EdduDesarrollo/digitalizadora-films/README.md

**Español** | [English](docs/README.en.md)

# AGU printer film scanner
La digitalización de películas fotoquímicas es una necesidad de todos los archivos y colecciones.
A pesar de que en los últimos años han bajado considerablemente los costos de los equipos necesarios, todavía es inaccesible para los archivos y colecciones pequeñas.
Con esto en mente, en el Espacio de digitalización de documentos universitarios del Archivo General de la UDELAR nos abocamos a la tarea de desarrollar un sistema de escaneo de bajo costo y replicable por otras instituciones y particulares que cumpla con ciertos criterios de calidad y sustentabilidad.



## Componentes



1. Una impresora de tickets de las utilizadas en los puestos de venta.



2. Una cámara digital compatible con el software [gphoto2](http://www.gphoto.org/proj/libgphoto2/support.php).

3. Un lente macro o aros de extensión.

4. Una computadora de mediana potencia con sistema operativo Ubuntu.



5. Un plafón de iluminación led cuadrado de aprox 11 cm de lado.



6. Partes que fueron impresas en 3D:
Soporte y agarraderas para plafón de iluminación.

Base, tapa y trancas para películas de 16mm y 35mm.

7. Un tablón de madera como base de todos los elementos.

8. Un pie de ampliadora como soporte de la cámara.

9. Dos antiguas rebobinadoras de película.

## Principio de funcionamiento



Se utiliza el mecanismo de mover el papel de la impresora para traccionar la película. Para ello es necesario hacerle unas pequeñas modificaciones:

1. Tapar el sensor de falta de papel con un adhesivo.



2. Realizar un pequeño corte en el plástico de la tapa por donde va a entrar la película.



3. Remover el eje de la tapa para poder quitarla al enhebrar la película.



Para este proceso no es exclusivo contar con una impresora de tickets, sino que puede utilizarse cualquier impresora térmica genérica. No obstante, las modificaciones podrían tener que adaptarse a la forma de la impresora.

4. Como fuente de luz se utiliza un plafón genérico de led.

5. Se realizan unas piezas impresas en 3D para colocar la fuente de luz a la misma altura que la entrada de la cinta en la impresora y unas guías para llevar la película sobre la ventana hecha en el soporte.

<em>Los archivos .stl están en la carpeta <a href="docs/">docs</a> del repositorio</em>

6. La cámara con lente macro se sitúa sobre el soporte a una altura adecuada para encuadrar el fotograma. En nuestro caso usamos un pie de una vieja ampliadora fotográfica para sostener la cámara.



7. Tanto la cámara como la impresora se conectan con la computadora mediante cables usb por lo que no es necesario realizar ningún tipo de conexión extra ni soldaduras.

## Software

Print-Scanner_es

Todo el sistema se maneja con una app que controla la cámara mediante la librería gphoto2 y manipula las imágenes mediante opencv. Por el momento, esta app funciona sólo sobre sistema operativo linux pero es posible portarlo a macOS.

Cuando se comienza a utilizar el software por primera vez, es necesario ingresar:

1. Número de serie de la cámara
2. El prefijo del código de referencia (Ej: UY-UDELAR-AGU-AIH). Todo nuestro acervo está dentro de este código por lo que lo usamos como prefijo para todas las digitalizaciones.
3. Seleccionar el directorio donde se van a guardar las imágenes.
4. Ingresar el código de referencia a escanear (Lo que seguiría luego del prefijo - Ej: I-AGU-02-01)
5. Luego, se debe seleccionar el formato de la película. Por el momento, el sistema funciona con películas de 16 mm (se está trabajando para incluir también las de 35 mm, aunque aún no se ha puesto a prueba con el acervo del archivo). En el futuro también se podrá trabajar con películas de 8mm y Súper 8.
 
Una vez que se selecciona el formato, en la interfaz del programa se verá el liveview  (visualización en directo) que toma la cámara con tres líneas azules superpuestas al liveview, que sirven para alinear la cámara con la película, el área en rojo donde el sistema buscará la perforación, además de algunos botones de configuración y reproducción  en la parte inferior derecha de la pantalla y en la parte inferior cuatro botones (Digitalizar, Pausar, Mover 1px y Frame x Frame).

Antes de comenzar es necesario ajustar el foco y otras configuraciones de la cámara.
Esto se hace a través del programa Entangle, al cual se puede acceder a través del botón “Ajustes” (tecla E). Una vez realizados los ajustes, se debe retornar al liveview y configurar el nivel de umbralización (tecla Y) para que se pueda detectar las perforaciones. Una vez configurado el nivel de umbralización se tiene que setear el nivel mínimo de pixeles blancos. Para esto es necesario "Activar Debug" (o tecla G), la pantalla se pintará de rojo, y comenzar la digitalización (tecla Z).
En ese momento se abren dos ventanas, una con los datos analizados y otra con lo que está detectando en la zona donde busca la perforación.
En ese momento se pueden hacer tres acciones: 
1. Cerrar las ventanas con la tecla Q.
2. Avanzar el film un píxel para que analice nuevamente la nueva posición con la tecla E _(Funciona solo en el debug)_.
3. Desactivar el modo Debug y reanudar la digitalización de forma normal con la tecla R.

Lo que nos sirve en esta etapa es avanzar un píxel hasta que la perforación esté completa en la ventana de búsqueda para ver la cantidad de pixeles blancos para ingresar ese valor, o unos pixeles menos, en la opción "Umbral Px Blancos" (tecla U). Luego, si está todo correcto, se puede comenzar el escaneo.

El botón de "Mover 1px" (tecla C) permite avanzar de a un píxel hasta la parte que se quiere empezar a digitalizar.
El botón de "Pausar" (tecla P), sirve para pausar la digitalización en cualquier momento.
Para comenzar el escaneo basta con hacer clic en el botón "Digitalizar" (tecla Z).
 
## Escaneo

El escaneo comienza con la identificación de la perforación mediante el conteo de la cantidad de píxeles blancos en la zona indicada con el recuadro rojo. De no identificar la perforación, la impresora mueve la película de a un píxel hasta encontrar la perforación.

Para los casos con más de una perforación por cuadro, como las películas de 35 mm, el sistema cuenta las perforaciones hasta identificar el cambio de cuadro. Luego de esto, el proceso de digitalización es el mismo.

Por el momento, los carretes no cuentan con motores, por lo que es necesario que una persona suelte y recoja la película manualmente. Para acelerar el proceso de escaneo, el sistema no guarda las imágenes en la carpeta de destino sino que  los archivos raws (tif, cr3, u otros según la cámara) se guardan en la tarjeta de memoria de la cámara y se guarda la relación del nombre de la imagen de la cámara con el nombre que debería tener. Cuando existe un archivo raw en la cámara, el botón “Descargar Raws” cambia a color rojo, avisando que hay archivos pendientes de descarga.

Durante el proceso de escaneo es necesario limpiar todo el sistema cada cierta cantidad de fotos por lo que lo configuramos para que se detenga cada 500 cuadros. Usando aire (pera de goma o aire comprimido) se limpia la zona que se captura removiendo cualquier impureza que se pudo haber desprendido de la película. También aprovechamos esa pausa para descargar las imágenes raws, donde el sistema descargará las imágenes y las renombra con el nombre y número que se configuró.
 
## Posproducción

Una vez que el escaneo de la película está finalizado, se obtiene una secuencia de fotos digitales numeradas en correspondencia con los cuadros fotoquímicos de la película original. Luego de esto, es necesario un proceso de estabilización digital para corregir los pequeños desfasajes en la toma de las fotos digitales. Una posibilidad para hacerlo es mediante el software de edición de video Davinci Resolve, que tiene una versión gratuita. 
 
## Ventajas y desventajas

La principal ventaja de este sistema es su bajo costo. El componente más caro es la cámara fotográfica, aunque puede utilizarse una cámara sencilla que cumpla con los requisitos de ser compatible con gphoto 2 y contar con un lente macro. Al tratarse de un sistema modular, puede mejorarse progresivamente si se dispone de un presupuesto mayor. En el AGU se utilizó una cámara sin espejo ya descontinuada, de 32 megapíxeles, suficiente para obtener una resolución de 4K (aprox. USD 700), un lente de 50mm (aprox. USD 300) y aros de extensión (aprox. USD 100). La computadora empleada es una de las disponibles en el archivo, con una antigüedad de cuatro años. Las piezas impresas en 3D se produjeron con un equipo muy sencillo, que costó unos USD 300, aunque también pueden fabricarse mediante servicios externos de impresión.

Otra ventaja es su sencillez, dado que no es necesario contar con un conocimiento avanzado de informática para instalar y operar el sistema. El sistema también destaca por su versatilidad. Si bien el diseño se desarrolló inicialmente para la digitalización de películas de 16mm, que conforman la parte más voluminosa del acervo del AGU, es posible adaptar las guías y la app para otros formatos.

Una desventaja es que, por el momento, el sistema solamente puede utilizarse en Ubuntu. Aunque es posible migrarlo a macOS mediante algunas modificaciones, aún no puede ejecutarse en Windows, dado que la librería gphoto2 no es compatible con ese entorno.
 
## Próximos pasos

Como se mencionó anteriormente, este es un proyecto en desarrollo. Tras ponerlo a prueba durante los últimos meses identificamos algunas mejoras a realizar:
- Motorizar los carretes de alimentación de película.
- Desarrollar la adaptación para películas de 35 y 8 mm.
- Mejoras estéticas en la interfaz de usuario.

## Guía de Instalación, Configuración y Ejecución de la app

Este documento proporciona los pasos necesarios para preparar y ejecutar la app correctamente.

## Paso 1: Instalar Python 3

Asegúrate de tener Python 3 instalado en tu sistema. Puedes instalarlo desde apt usando la terminal.

   ```bash
   sudo apt update
   sudo apt install python3 python3-pip
   ```

Para corroborar que python3 haya sido instalado correctamente puedes ejecutar el siguiente comando en la terminal:
   ```bash
   python3 --version
   ```

## Paso 2: Instalar dependencias de la app

1. **Instalar paquetes del sistema y acceso directo:**

   Abre una terminal y ejecuta el siguiente comando, desde la raíz del repositorio, para instalar las dependencias de la app:

   ```bash
   python3 print_scanner_app/installer/install.py
   ```

2. **Verificar el Acceso Directo:**

   Ahora deberías ver el acceso directo en tu escritorio. Haz doble clic para ejecutar el programa.

## Paso 3: Obtener el Número de Serie de la Cámara Usando la Terminal

1. **Conectar la Cámara:**

   Asegúrate de que tu cámara esté conectada al puerto USB de tu computadora.

2. **Listar Dispositivos Conectados:**

   Ejecuta el siguiente comando para listar los dispositivos conectados y verificar que tu cámara sea reconocida:

   ```bash
   gphoto2 --auto-detect
   ```

   Esto debería mostrar una lista de dispositivos conectados, incluyendo tu cámara.

3. **Obtener el Número de Serie:**

   Una vez que hayas confirmado que la cámara está conectada y reconocida, ejecuta el siguiente comando para obtener el número de serie:

   ```bash
   gphoto2 --get-config serialnumber
   ```

   Este comando debería devolver el número de serie de la cámara.

   Al iniciar el programa te pedirá el número de serie de la cámara si no está configurado en el archivo config.json

---

Con estos pasos completados, deberías estar listo para ejecutar la app sin problemas.
Si encuentras algún problema, revisa cada paso para asegurarte de que todo esté configurado correctamente.
