EdduDesarrollo/digitalizadora-films/Utils/Pending_raws/README.md

## Aquí se va van a generar archivos .txt con los nombres de las imagenes pendientes de descarga ##
