EdduDesarrollo/digitalizadora-films/docs/modelo_completo_35mm_v1-Tranca.stl

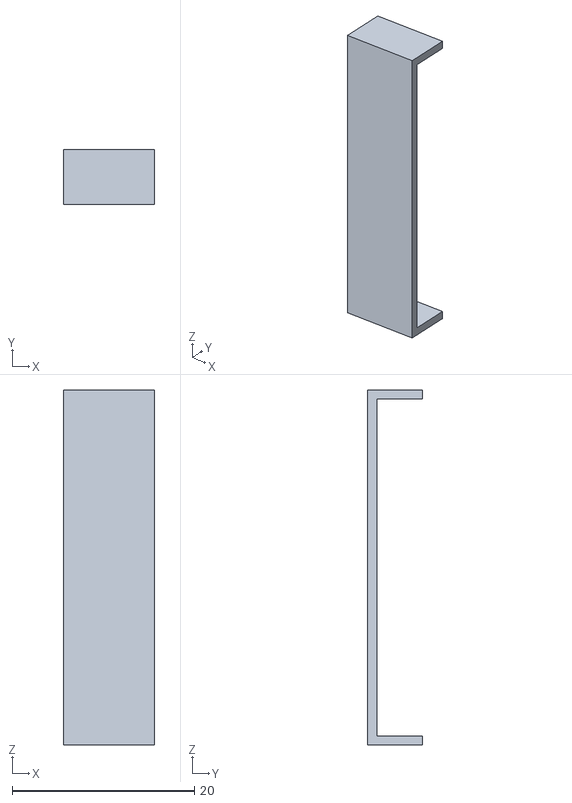
[picture p1: CAD file, 2026-09-23]
docs/modelo_completo_35mm_v1-Tranca.stl
10.0 x 6.00 x 39.0
