EdduDesarrollo/digitalizadora-films/docs/modelo_completo_35mm_v1-TAPA.stl

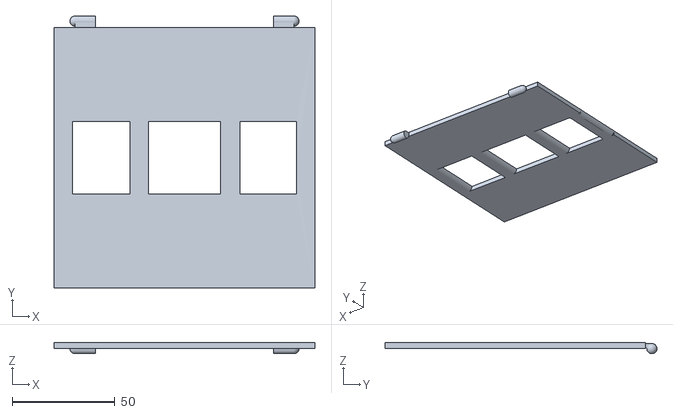
[picture p2: CAD file, 2025-10-21]
docs/modelo_completo_35mm_v1-TAPA.stl
127.0 x 132.6 x 5.60
