EdduDesarrollo/digitalizadora-films/docs/modelo_agarraderas_soporte.stl

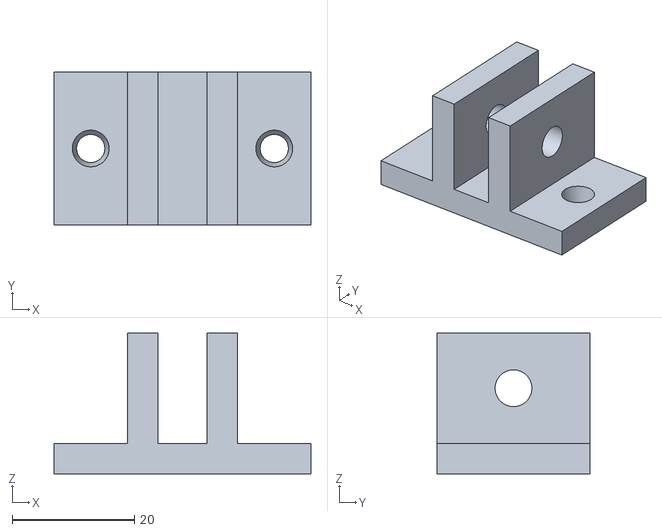
[picture p3: CAD file, 2025-10-21]
docs/modelo_agarraderas_soporte.stl
42.0 x 25.0 x 23.0
