EdduDesarrollo/digitalizadora-films/docs/modelo_completo_16mm_v5-TAPA.stl

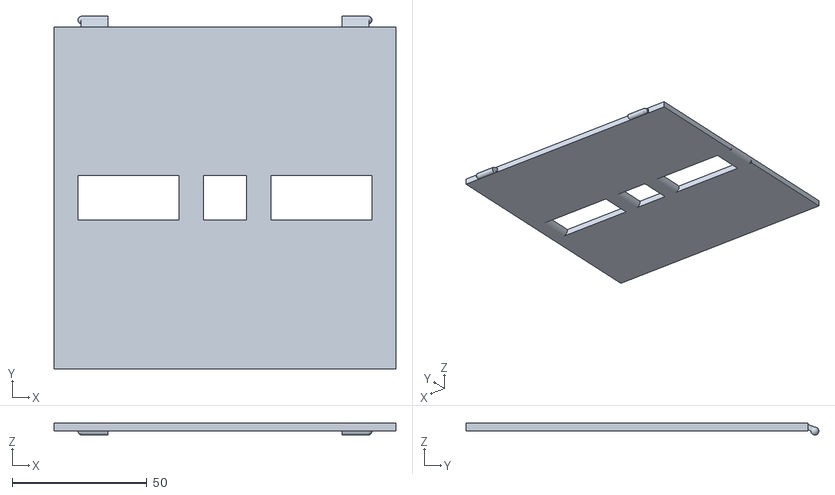
[picture p4: CAD file, 2025-10-21]
docs/modelo_completo_16mm_v5-TAPA.stl
127.0 x 131.0 x 4.49
