EdduDesarrollo/digitalizadora-films/docs/modelo_soporte.stl

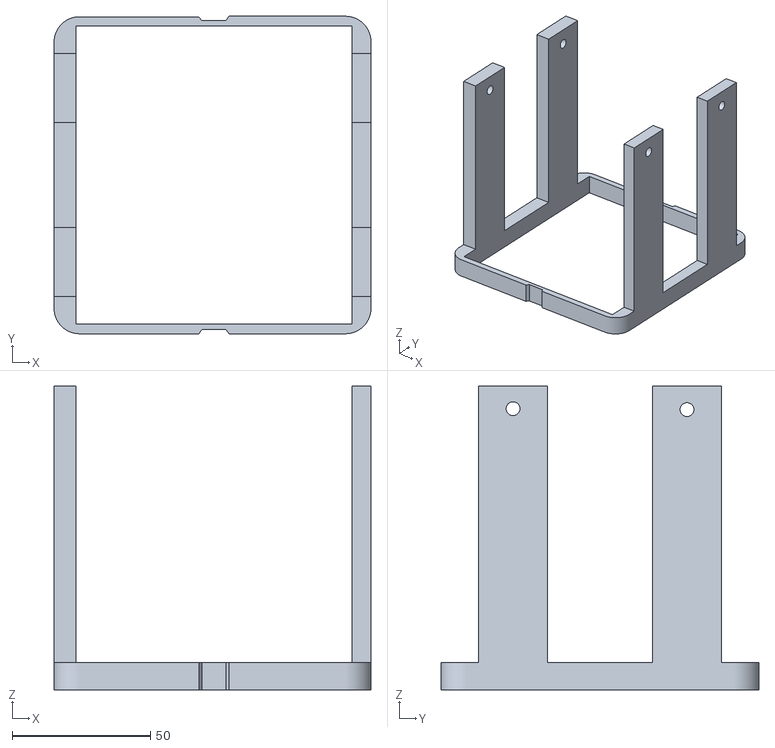
[picture p5: CAD file, 2025-10-21]
docs/modelo_soporte.stl
114.8 x 115.0 x 110.0
