EdduDesarrollo/digitalizadora-films/docs/modelo_completo_35mm_v1-BASE.stl

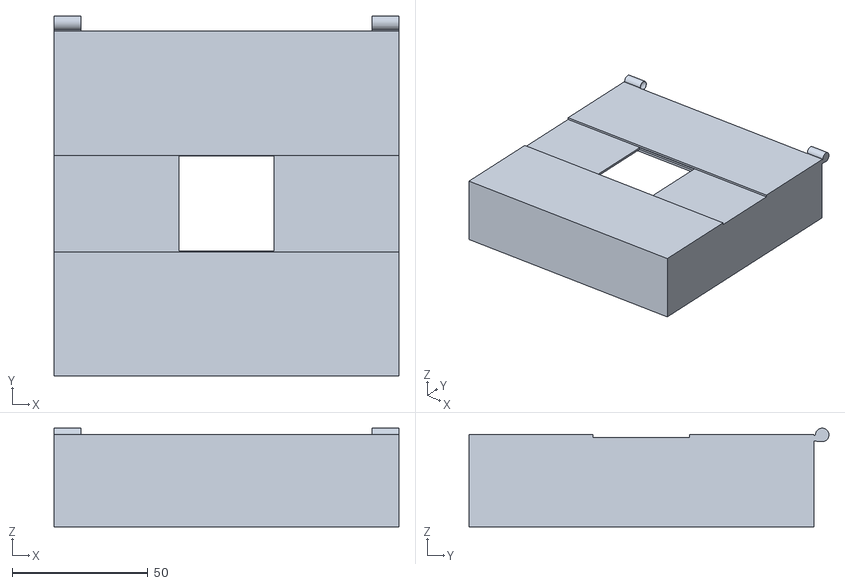
[picture p6: CAD file, 2025-10-21]
docs/modelo_completo_35mm_v1-BASE.stl
127.0 x 132.6 x 36.4
