EdduDesarrollo/digitalizadora-films/docs/modelo_Tranca.stl

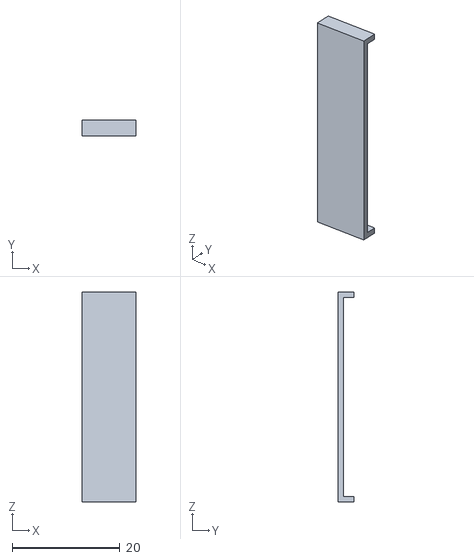
[picture p7: CAD file, 2025-10-21]
docs/modelo_Tranca.stl
10.0 x 3.00 x 39.0
