EdduDesarrollo/digitalizadora-films/docs/modelo_completo_16mm_v5-BASE.stl

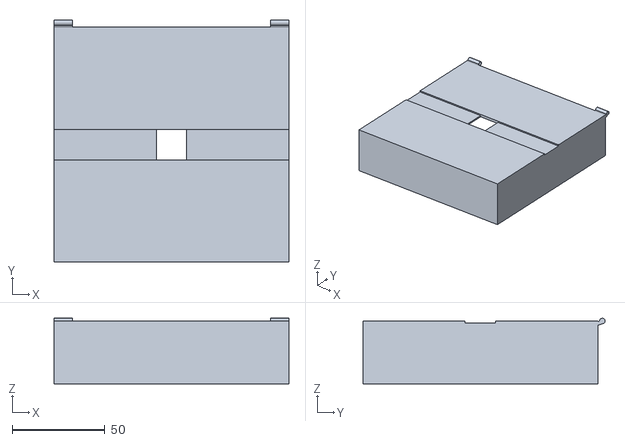
[picture p8: CAD file, 2025-10-21]
docs/modelo_completo_16mm_v5-BASE.stl
127.0 x 131.0 x 35.5
