EdduDesarrollo/digitalizadora-films/(commit log)

2025-10-21 First commit
    First commit
    [Agarraderas_soporte.stl, Base_16mm.stl, Base_35mm.stl, Soporte.stl, Tapa_16mm.stl, Tapa_35mm.stl, Tranca.stl]
2026-05-29 Revise README for AGU printer film scanner project
    Updated the README to provide detailed information about the AGU printer film scanner project, including components, functioning principles, software usage, scanning process, post-production, advantages and disadvantages, and next steps.
2026-05-29 Document AGU printer film scanner setup and operation
    Added detailed information about the AGU printer film scanner, including components, operating principles, and software requirements.
2026-05-29 Remove reference to 3D model of film guide
    Removed the mention of the 3D model of the 16mm film guide from the README.
2026-09-18 #UPDATE: Se realiza migración a nueva versión
    [Agarraderas_soporte.stl, Base_16mm.stl, Base_35mm.stl, Soporte.stl, Tapa_16mm.stl, Tapa_35mm.stl, Tranca.stl]
2026-09-18 #UPDATE: Se agrega cambio de idioma en readme
2026-09-21 Update README.md
    Cambio de imagen del programa
2026-09-21 Update README.en.md
    Cambio de imagen del programa para el readme en inglés
2026-09-23 FIX: Solucionar captura que no guarda la imagen en la camara
2026-09-23 FIX: Ajuste en el archivo gitignore
2026-09-23 #FIX: Se sacan los archivos pychache del tracker de git
2026-09-23 #FIX: Se sacan los archivos log del tracker de git
2026-09-23 #UPDATE: Cambio de versión 1.0.2
2026-09-23 Se agregan archivos stl
    [modelo_Tranca.stl, modelo_agarraderas_soporte.stl, modelo_completo_16mm_v5-BASE.stl, modelo_completo_16mm_v5-TAPA.stl, modelo_completo_35mm_v1-BASE.stl, modelo_completo_35mm_v1-TAPA.stl, modelo_completo_35mm_v1-Tranca.stl, modelo_soporte.stl]
2026-09-23 #UPDATE: se cambia mensaje de limpiar y se traduce datos que se muestran en el debug
2026-09-28 #FIX: Solve bug to stop on 500 frames
